enggsajjad/DataLogger/FPGA_Logger_R0000/main_pad.csv

Release 6.1i - Par G.23
Copyright (c) 1995-2003 Xilinx | Inc. All rights reserved.
Fri Nov 14 15:46:14 2014
NOTE: This file is designed to be imported into a spreadsheet program
such as Microsoft Excel for viewing | printing and sorting. The
character is used as the data field separator. This file is also designed
to support parsing.
INPUT FILE: main_map.ncd
OUTPUT FILE: main_pad.csv
PART TYPE: xc2s200
SPEED GRADE: -6
PACKAGE: pq208
Pinout by Pin Number:
----- | ----- | ----- | ----- | ----- | ----- | ----- | ----- | ----- | ----- | ----- | ----- | -----
Pin Number | Signal Name | Pin Usage | Pin Name | Direction | IO Standard | IO Bank Number | Drive (mA) | Slew Rate | Termination | IOB Delay | Voltage | Constraint
P1 |  |  | GND
P10 |  | IOB |  | UNUSED |  | (0 | 7)***
P100 | CSu | IOB | IO_VREF_4 | INPUT | LVTTL | (0 | 4)*** |  |  |  | NONE |  | LOCATED
P101 |  | IOB |  | UNUSED |  | (0 | 4)***
P102 |  | IOB |  | UNUSED |  | (0 | 4)***
P103 |  |  | GND
P104 |  |  | DONE
P105 |  |  | VCCO |  |  | 0 |  |  |  |  | 3.30
P106 |  |  | PROGRAM
P107 |  | IOB | IO_INIT | UNUSED |  | (0 | 3)***
P108 |  | IOB | IO_D7 | UNUSED |  | (0 | 3)***
P109 | sel_uart | IOB | IO_VREF_3 | INPUT | LVTTL | (0 | 3)*** |  |  |  | NONE |  | LOCATED
P11 |  |  | GND
P110 |  | IOB |  | UNUSED |  | (0 | 3)***
P111 | pCLK | IOB | IO_VREF_3 | OUTPUT | LVTTL | (0 | 3)*** | 12 | SLOW | NONE** |  |  | LOCATED
P112 |  | IOB |  | UNUSED |  | (0 | 3)***
P113 |  | IOB |  | UNUSED |  | (0 | 3)***
P114 |  | IOB | IO_VREF_3 | UNUSED |  | (0 | 3)***
P115 |  | IOB | IO_D6 | UNUSED |  | (0 | 3)***
P116 |  |  | GND
P117 |  |  | VCCO |  |  | 0 |  |  |  |  | 3.30
P118 |  |  | VCCINT |  |  |  |  |  |  |  | 2.5
P119 |  | IOB | IO_D5 | UNUSED |  | (0 | 3)***
P12 |  |  | VCCO |  |  | 0 |  |  |  |  | 3.30
P120 |  | IOB |  | UNUSED |  | (0 | 3)***
P121 |  | IOB |  | UNUSED |  | (0 | 3)***
P122 |  | IOB |  | UNUSED |  | (0 | 3)***
P123 |  | IOB |  | UNUSED |  | (0 | 3)***
P124 |  |  | GND
P125 |  | IOB | IO_VREF_3 | UNUSED |  | (0 | 3)***
P126 |  | IOB | IO_D4 | UNUSED |  | (0 | 3)***
P127 |  | IOB |  | UNUSED |  | (0 | 3)***
P128 |  |  | VCCINT |  |  |  |  |  |  |  | 2.5
P129 |  | PCIIOB | IO_TRDY | UNUSED |  | (0 | 3)***
P13 |  |  | VCCINT |  |  |  |  |  |  |  | 2.5
P130 |  |  | VCCO |  |  | 0 |  |  |  |  | 3.30
P131 |  |  | GND
P132 |  | PCIIOB | IO_IRDY | UNUSED |  | (0 | 2)***
P133 |  | IOB |  | UNUSED |  | (0 | 2)***
P134 |  | IOB |  | UNUSED |  | (0 | 2)***
P135 |  | IOB | IO_D3 | UNUSED |  | (0 | 2)***
P136 |  | IOB | IO_VREF_2 | UNUSED |  | (0 | 2)***
P137 |  |  | GND
P138 |  | IOB |  | UNUSED |  | (0 | 2)***
P139 |  | IOB |  | UNUSED |  | (0 | 2)***
P14 | sw<4> | IOB |  | INPUT | LVTTL | (0 | 7)*** |  |  |  | NONE |  | LOCATED
P140 |  | IOB |  | UNUSED |  | (0 | 2)***
P141 |  | IOB |  | UNUSED |  | (0 | 2)***
P142 |  | IOB | IO_D2 | UNUSED |  | (0 | 2)***
P143 |  |  | VCCINT |  |  |  |  |  |  |  | 2.5
P144 |  |  | VCCO |  |  | 0 |  |  |  |  | 3.30
P145 |  |  | GND
P146 |  | IOB | IO_D1 | UNUSED |  | (0 | 2)***
P147 | RXpc | IOB | IO_VREF_2 | OUTPUT | LVTTL | (0 | 2)*** | 12 | SLOW | NONE** |  |  | LOCATED
P148 | TXpc | IOB |  | INPUT | LVTTL | (0 | 2)*** |  |  |  | NONE |  | LOCATED
P149 |  | IOB |  | UNUSED |  | (0 | 2)***
P15 |  | IOB |  | UNUSED |  | (0 | 7)***
P150 |  | IOB | IO_VREF_2 | UNUSED |  | (0 | 2)***
P151 |  | IOB |  | UNUSED |  | (0 | 2)***
P152 |  | IOB | IO_VREF_2 | UNUSED |  | (0 | 2)***
P153 |  | IOB | IO_DIN_D0 | UNUSED |  | (0 | 2)***
P154 |  | IOB | IO_DOUT_BUSY | UNUSED |  | (0 | 2)***
P155 |  |  | CCLK
P156 |  |  | VCCO |  |  | 0 |  |  |  |  | 3.30
P157 |  |  | TDO
P158 |  |  | GND
P159 |  |  | TDI
P16 |  | IOB |  | UNUSED |  | (0 | 7)***
P160 |  | IOB | IO_CS | UNUSED |  | (0 | 1)***
P161 |  | IOB | IO_WRITE | UNUSED |  | (0 | 1)***
P162 | SCLK1 | IOB | IO_VREF_1 | OUTPUT | LVTTL | (0 | 1)*** | 12 | SLOW | NONE** |  |  | LOCATED
P163 |  | IOB |  | UNUSED |  | (0 | 1)***
P164 | CLK1 | IOB | IO_VREF_1 | OUTPUT | LVTTL | (0 | 1)*** | 12 | SLOW | NONE** |  |  | LOCATED
P165 |  | IOB |  | UNUSED |  | (0 | 1)***
P166 |  | IOB |  | UNUSED |  | (0 | 1)***
P167 |  | IOB | IO_VREF_1 | UNUSED |  | (0 | 1)***
P168 | CS1 | IOB |  | OUTPUT | LVTTL | (0 | 1)*** | 12 | SLOW | NONE** |  |  | LOCATED
P169 |  |  | GND
P17 |  | IOB |  | UNUSED |  | (0 | 7)***
P170 |  |  | VCCO |  |  | 0 |  |  |  |  | 3.30
P171 |  |  | VCCINT |  |  |  |  |  |  |  | 2.5
P172 | nDRDY | IOB |  | INPUT | LVTTL | (0 | 1)*** |  |  |  | IFD |  | LOCATED
P173 |  | IOB |  | UNUSED |  | (0 | 1)***
P174 | SDOUT1 | IOB |  | INPUT | LVTTL | (0 | 1)*** |  |  |  | IFD |  | LOCATED
P175 |  | IOB |  | UNUSED |  | (0 | 1)***
P176 | filter_clk | IOB |  | OUTPUT | LVTTL | (0 | 1)*** | 12 | SLOW | NONE** |  |  | LOCATED
P177 |  |  | GND
P178 | SYNC1 | IOB | IO_VREF_1 | OUTPUT | LVTTL | (0 | 1)*** | 12 | SLOW | NONE** |  |  | LOCATED
P179 |  | IOB |  | UNUSED |  | (0 | 1)***
P18 |  | IOB |  | UNUSED |  | (0 | 7)***
P180 |  | IOB |  | UNUSED |  | (0 | 1)***
P181 |  | IOB |  | UNUSED |  | (0 | 1)***
P182 | clk | GCLKIOB | GCK2 | INPUT | LVTTL | (0 | 1)*** |  |  |  |  |  | LOCATED
P183 |  |  | GND
P184 |  |  | VCCO |  |  | 0 |  |  |  |  | 3.30
P185 |  | GCLKIOB | GCK3 | UNUSED |  | 0
P186 |  |  | VCCINT |  |  |  |  |  |  |  | 2.5
P187 |  | IOB |  | UNUSED |  | 0
P188 |  | IOB |  | UNUSED |  | 0
P189 |  | IOB | IO_VREF_0 | UNUSED |  | 0
P19 |  |  | GND
P190 |  |  | GND
P191 |  | IOB |  | UNUSED |  | 0
P192 |  | IOB |  | UNUSED |  | 0
P193 |  | IOB |  | UNUSED |  | 0
P194 |  | IOB |  | UNUSED |  | 0
P195 |  | IOB |  | UNUSED |  | 0
P196 |  |  | VCCINT |  |  |  |  |  |  |  | 2.5
P197 |  |  | VCCO |  |  | 0 |  |  |  |  | 3.30
P198 |  |  | GND
P199 | relayAp | IOB |  | OUTPUT | LVTTL | 0 | 12 | SLOW | NONE** |  |  | LOCATED
P2 |  |  | TMS
P20 |  | IOB | IO_VREF_7 | UNUSED |  | (0 | 7)***
P200 |  | IOB | IO_VREF_0 | UNUSED |  | 0
P201 | relayAn | IOB |  | OUTPUT | LVTTL | 0 | 12 | SLOW | NONE** |  |  | LOCATED
P202 |  | IOB |  | UNUSED |  | 0
P203 | relayBp | IOB | IO_VREF_0 | OUTPUT | LVTTL | 0 | 12 | SLOW | NONE** |  |  | LOCATED
P204 |  | IOB |  | UNUSED |  | 0
P205 | relayBn | IOB | IO_VREF_0 | OUTPUT | LVTTL | 0 | 12 | SLOW | NONE** |  |  | LOCATED
P206 |  | IOB |  | UNUSED |  | 0
P207 |  |  | TCK
P208 |  |  | VCCO |  |  | 0 |  |  |  |  | 3.30
P21 |  | IOB |  | UNUSED |  | (0 | 7)***
P22 |  | IOB |  | UNUSED |  | (0 | 7)***
P23 |  | IOB |  | UNUSED |  | (0 | 7)***
P24 |  | PCIIOB | IO_IRDY | UNUSED |  | (0 | 7)***
P25 |  |  | GND
P26 |  |  | VCCO |  |  | 0 |  |  |  |  | 3.30
P27 |  | PCIIOB | IO_TRDY | UNUSED |  | (0 | 6)***
P28 |  |  | VCCINT |  |  |  |  |  |  |  | 2.5
P29 |  | IOB |  | UNUSED |  | (0 | 6)***
P3 | sw<0> | IOB |  | INPUT | LVTTL | (0 | 7)*** |  |  |  | NONE |  | LOCATED
P30 |  | IOB |  | UNUSED |  | (0 | 6)***
P31 |  | IOB | IO_VREF_6 | UNUSED |  | (0 | 6)***
P32 |  |  | GND
P33 |  | IOB |  | UNUSED |  | (0 | 6)***
P34 |  | IOB |  | UNUSED |  | (0 | 6)***
P35 |  | IOB |  | UNUSED |  | (0 | 6)***
P36 |  | IOB |  | UNUSED |  | (0 | 6)***
P37 |  | IOB |  | UNUSED |  | (0 | 6)***
P38 |  |  | VCCINT |  |  |  |  |  |  |  | 2.5
P39 |  |  | VCCO |  |  | 0 |  |  |  |  | 3.30
P4 |  | IOB | IO_VREF_7 | UNUSED |  | (0 | 7)***
P40 |  |  | GND
P41 | CSe<1> | IOB |  | OUTPUT | LVTTL | (0 | 6)*** | 12 | SLOW | NONE** |  |  | LOCATED
P42 |  | IOB | IO_VREF_6 | UNUSED |  | (0 | 6)***
P43 | SCLKe | IOB |  | OUTPUT | LVTTL | (0 | 6)*** | 12 | SLOW | NONE** |  |  | LOCATED
P44 |  | IOB |  | UNUSED |  | (0 | 6)***
P45 | SDINe | IOB | IO_VREF_6 | OUTPUT | LVTTL | (0 | 6)*** | 12 | SLOW | NONE** |  |  | LOCATED
P46 |  | IOB |  | UNUSED |  | (0 | 6)***
P47 | SDOUTe | IOB | IO_VREF_6 | INPUT | LVTTL | (0 | 6)*** |  |  |  | NONE |  | LOCATED
P48 |  | IOB |  | UNUSED |  | (0 | 6)***
P49 | CSe<0> | IOB |  | OUTPUT | LVTTL | (0 | 6)*** | 12 | SLOW | NONE** |  |  | LOCATED
P5 | sw<1> | IOB |  | INPUT | LVTTL | (0 | 7)*** |  |  |  | NONE |  | LOCATED
P50 |  |  | M1
P51 |  |  | GND
P52 |  |  | M0
P53 |  |  | VCCO |  |  | 0 |  |  |  |  | 3.30
P54 |  |  | M2
P57 |  | IOB | IO_VREF_5 | UNUSED |  | (0 | 5)***
P58 |  | IOB |  | UNUSED |  | (0 | 5)***
P59 |  | IOB | IO_VREF_5 | UNUSED |  | (0 | 5)***
P6 |  | IOB | IO_VREF_7 | UNUSED |  | (0 | 7)***
P60 |  | IOB |  | UNUSED |  | (0 | 5)***
P61 | data_done | IOB |  | OUTPUT | LVTTL | (0 | 5)*** | 12 | SLOW | NONE** |  |  | LOCATED
P62 |  | IOB | IO_VREF_5 | UNUSED |  | (0 | 5)***
P63 | start_pulse | IOB |  | INPUT | LVTTL | (0 | 5)*** |  |  |  | IFD |  | LOCATED
P64 |  |  | GND
P65 |  |  | VCCO |  |  | 0 |  |  |  |  | 3.30
P66 |  |  | VCCINT |  |  |  |  |  |  |  | 2.5
P67 |  | IOB |  | UNUSED |  | (0 | 5)***
P68 | reset | IOB |  | INPUT | LVTTL | (0 | 5)*** |  |  |  | NONE |  | LOCATED
P69 |  | IOB |  | UNUSED |  | (0 | 5)***
P7 | sw<2> | IOB |  | INPUT | LVTTL | (0 | 7)*** |  |  |  | NONE |  | LOCATED
P70 |  | IOB |  | UNUSED |  | (0 | 5)***
P71 | CSe<3> | IOB |  | OUTPUT | LVTTL | (0 | 5)*** | 12 | SLOW | NONE**
P72 |  |  | GND
P73 | CSe<2> | IOB | IO_VREF_5 | OUTPUT | LVTTL | (0 | 5)*** | 12 | SLOW | NONE**
P74 |  | IOB |  | UNUSED |  | (0 | 5)***
P75 |  | IOB |  | UNUSED |  | (0 | 5)***
P76 |  |  | VCCINT |  |  |  |  |  |  |  | 2.5
P77 |  | GCLKIOB | GCK1 | UNUSED |  | (0 | 5)***
P78 |  |  | VCCO |  |  | 0 |  |  |  |  | 3.30
P79 |  |  | GND
P8 |  | IOB |  | UNUSED |  | (0 | 7)***
P80 |  | GCLKIOB | GCK0 | UNUSED |  | (0 | 4)***
P81 |  | IOB |  | UNUSED |  | (0 | 4)***
P82 |  | IOB |  | UNUSED |  | (0 | 4)***
P83 |  | IOB |  | UNUSED |  | (0 | 4)***
P84 | RXu | IOB | IO_VREF_4 | OUTPUT | LVTTL | (0 | 4)*** | 12 | SLOW | NONE** |  |  | LOCATED
P85 |  |  | GND
P86 | TXu | IOB |  | INPUT | LVTTL | (0 | 4)*** |  |  |  | NONE |  | LOCATED
P87 |  | IOB |  | UNUSED |  | (0 | 4)***
P88 | SDOUTu | IOB |  | INPUT | LVTTL | (0 | 4)*** |  |  |  | NONE |  | LOCATED
P89 |  | IOB |  | UNUSED |  | (0 | 4)***
P9 | sw<3> | IOB | IO_VREF_7 | INPUT | LVTTL | (0 | 7)*** |  |  |  | NONE |  | LOCATED
P90 | SDINu | IOB |  | OUTPUT | LVTTL | (0 | 4)*** | 12 | SLOW | NONE** |  |  | LOCATED
P91 |  |  | VCCINT |  |  |  |  |  |  |  | 2.5
P92 |  |  | VCCO |  |  | 0 |  |  |  |  | 3.30
P93 |  |  | GND
P94 | SCLKu | IOB |  | INPUT | LVTTL | (0 | 4)*** |  |  |  | NONE |  | LOCATED
P95 |  | IOB | IO_VREF_4 | UNUSED |  | (0 | 4)***
P96 |  | IOB |  | UNUSED |  | (0 | 4)***
P97 |  | IOB |  | UNUSED |  | (0 | 4)***
P98 |  | IOB | IO_VREF_4 | UNUSED |  | (0 | 4)***
P99 |  | IOB |  | UNUSED |  | (0 | 4)***
----- | ----- | ----- | ----- | ----- | ----- | ----- | ----- | ----- | ----- | ----- | ----- | -----
* Default value.
** This default Pullup/Pulldown value can be overridden in Bitgen.
*** In some smaller packages | the VCCO bank number of a pin may trail
the VREF bank number (VCCO | VREF).
