enggsajjad/DataLogger/ICCC-PD-24-PCBR0500/data logger-68.dxf

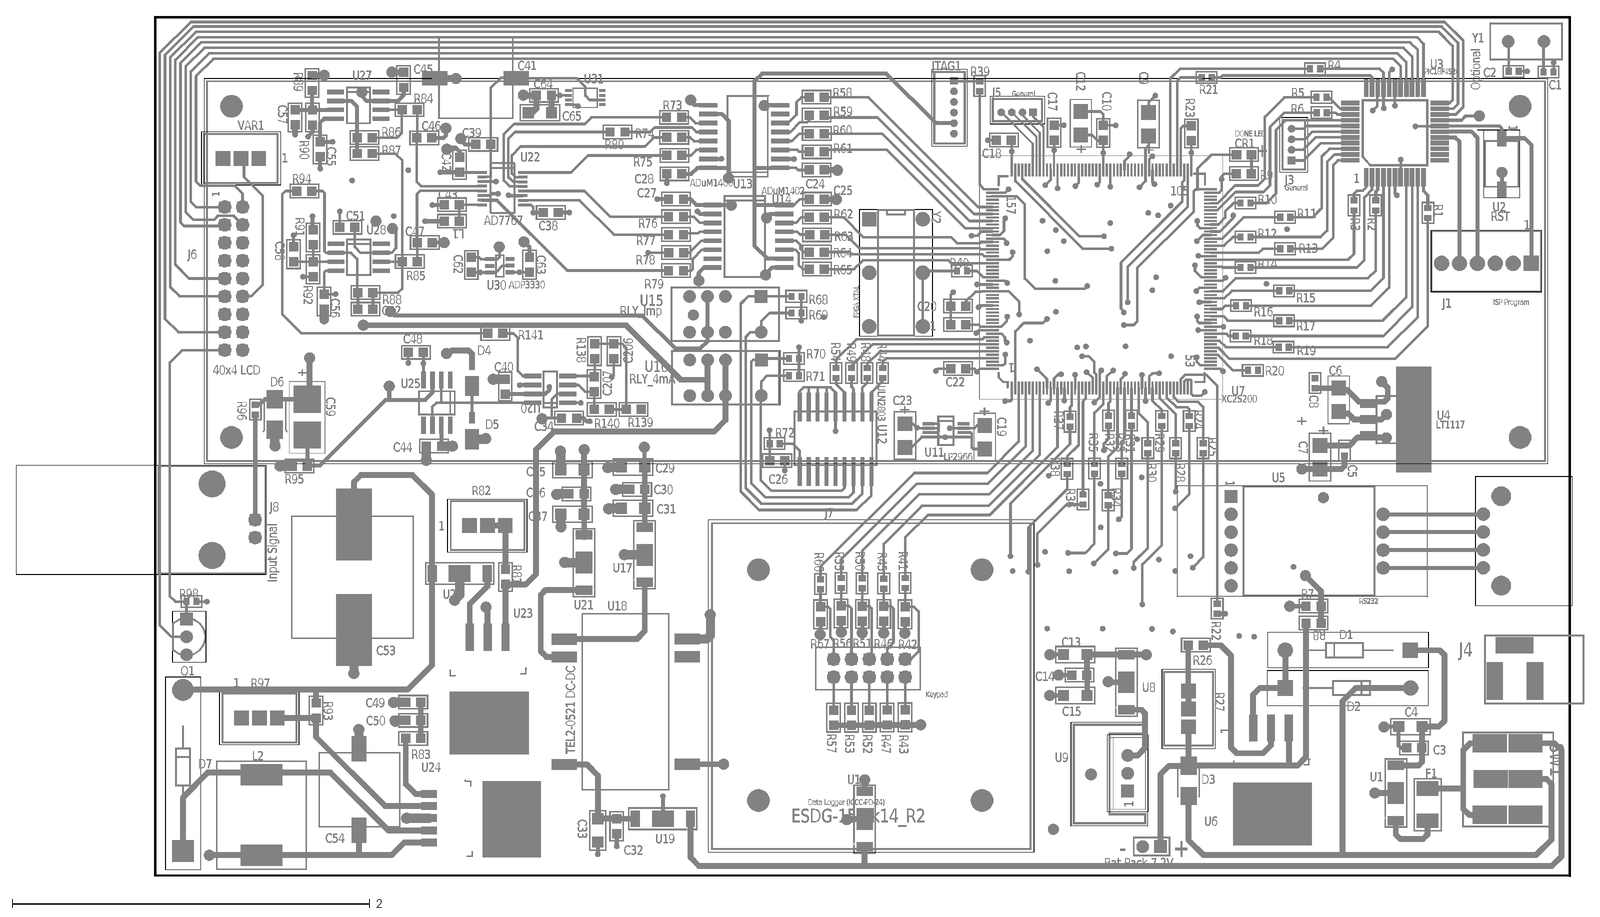
[picture p1: CAD file, 2022-11-24]
ICCC-PD-24-PCBR0500/data logger-68.dxf
U30
U23
U25
U27
U28
U1
U10
U8
U19
U17
U21
U26
C54
C53
C41
L2
C12
+
U18
U31
R71
J8
1
R27
R97
R82
VAR1
D7
J7
R22
J1
U5
C43
R15
C14
C27
C28
C13
C40
C37
R4
C15
C38
L1
C50
C65
C36
R28
R84
C64
C35
F1
R38
C55
R1
U24
U15
C45
U12
U20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
