enggsajjad/DataLogger/(list of files, cad)

Other CAD files:
FPGA_Logger_R0000/work/adc/verilog.psm
FPGA_Logger_R0000/work/buttons/verilog.psm
FPGA_Logger_R0000/work/cu_rx/verilog.psm
FPGA_Logger_R0000/work/glbl/verilog.psm
FPGA_Logger_R0000/work/relays/verilog.psm
FPGA_Logger_R0000/work/tf_adc/verilog.psm
FPGA_Logger_R0000/work/tf_button/verilog.psm
FPGA_Logger_R0000/work/tf_cu_rx/verilog.psm
FPGA_Logger_R0000/work/tf_relays/verilog.psm
FPGA_Logger_R0000/work/uart_rx/verilog.psm
