enggsajjad/DataLogger/ICCC-PD-24-PCBR0500/pdf/schematic.pdf

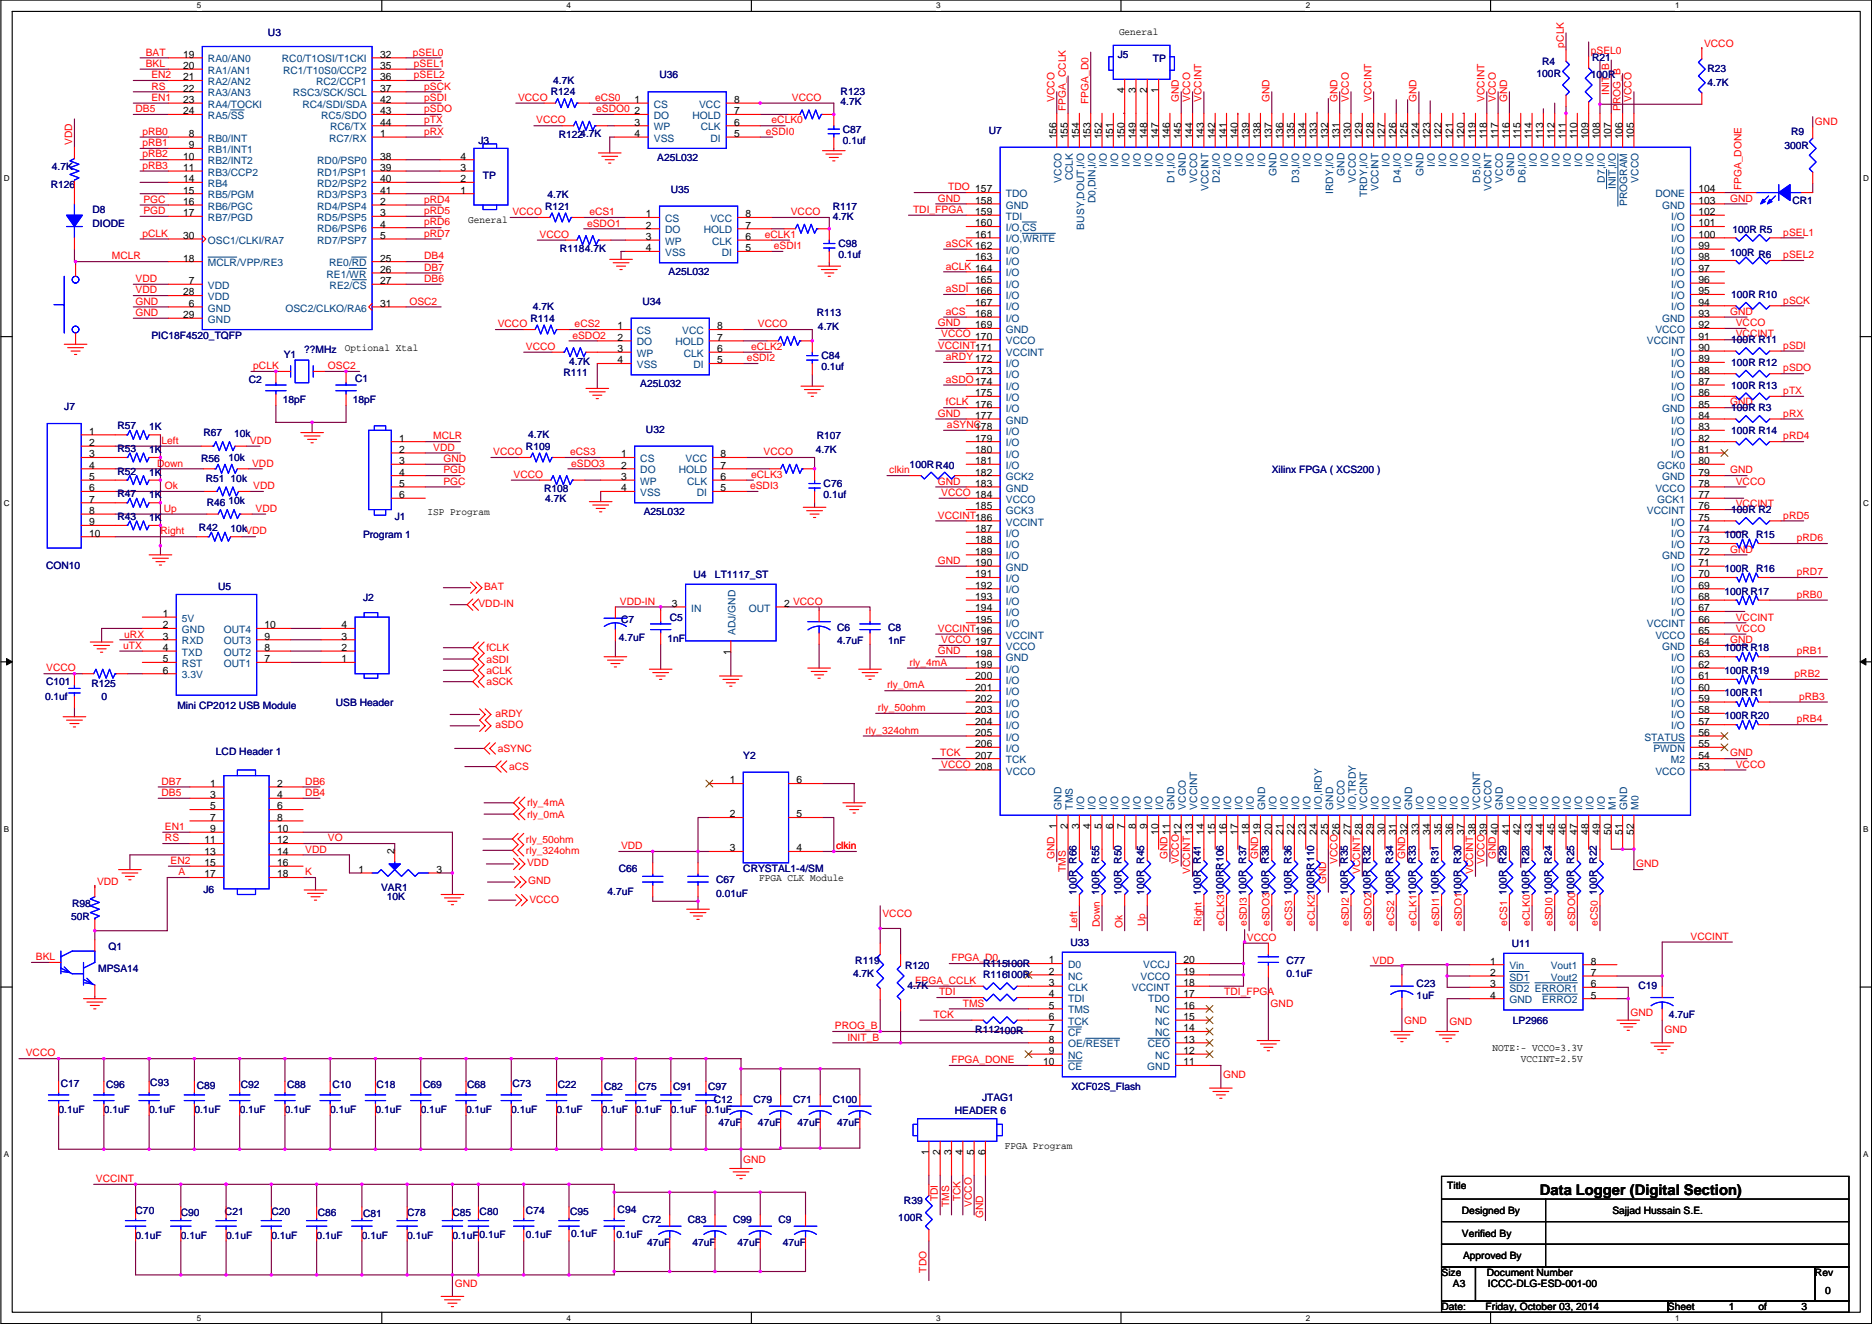
[picture p2: page 1]

ADJ/GND 1 IN 3 OUT 2

Data Logger (Digital Section)

Designed By Designed By Designed By | Sajjad Hussain S.E. Sajjad Hussain S.E. Sajjad Hussain S.E.

Verified By Verified By Verified By

Approved By
Size A3 | Document Number ICCC-DLG-ESD-001-00 | Rev 0

Date: Friday, October 03, 2014 Friday, October 03, 2014 Friday, October 03, 2014 | Sheet 1 1 1 of 3 3 3

VDD-IN | VDD

## VDD

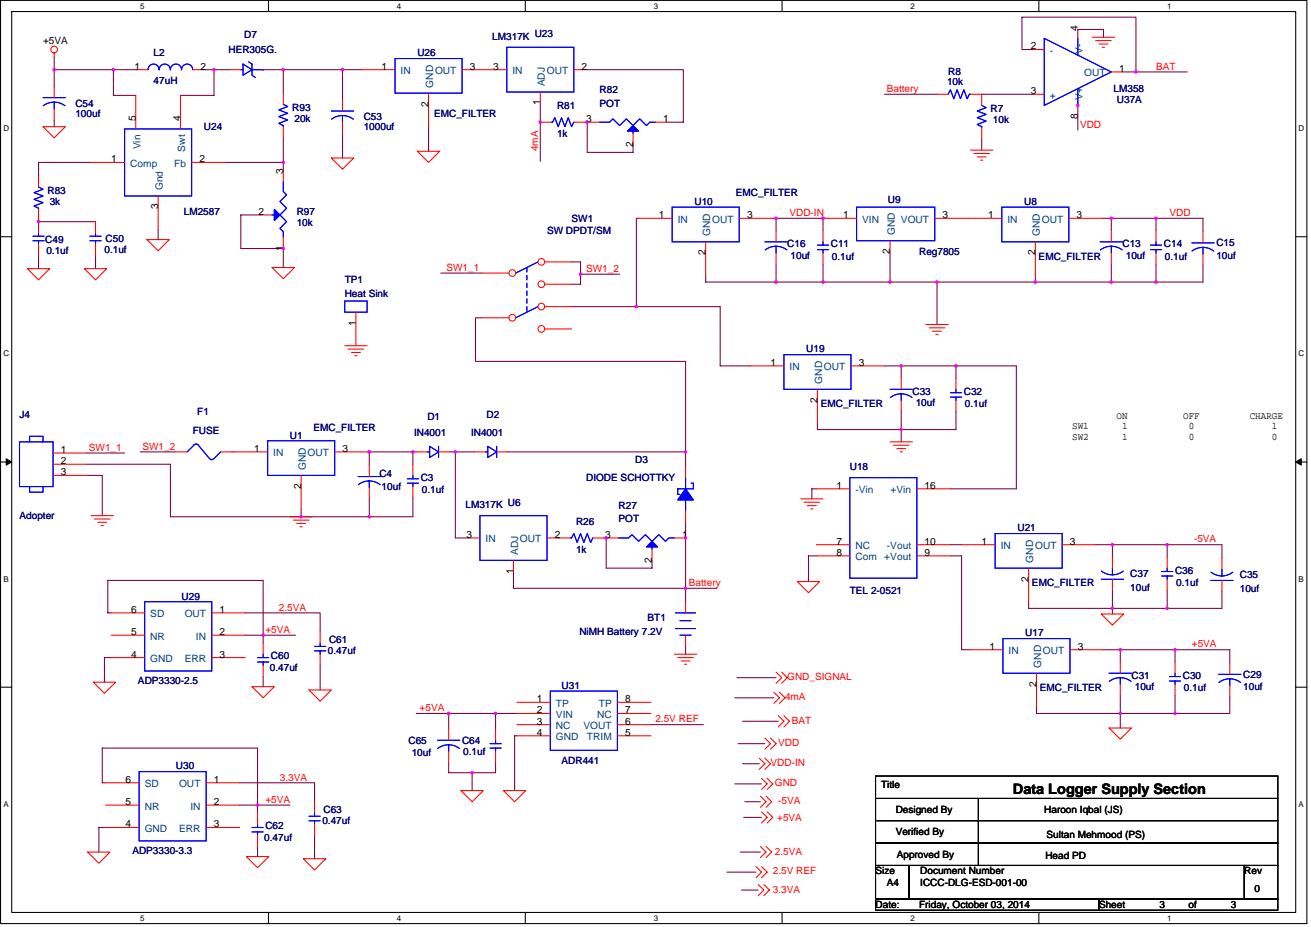
[picture p3: page 2]

Data Logger Supply Section

Designed By Designed By Designed By | Haroon Iqbal (JS) Haroon Iqbal (JS) Haroon Iqbal (JS)

Verified By Verified By Verified By | Sultan Mehmood (PS) Sultan Mehmood (PS) Sultan Mehmood (PS)

Head PD Head PD Head PD

+5VA

+5VA

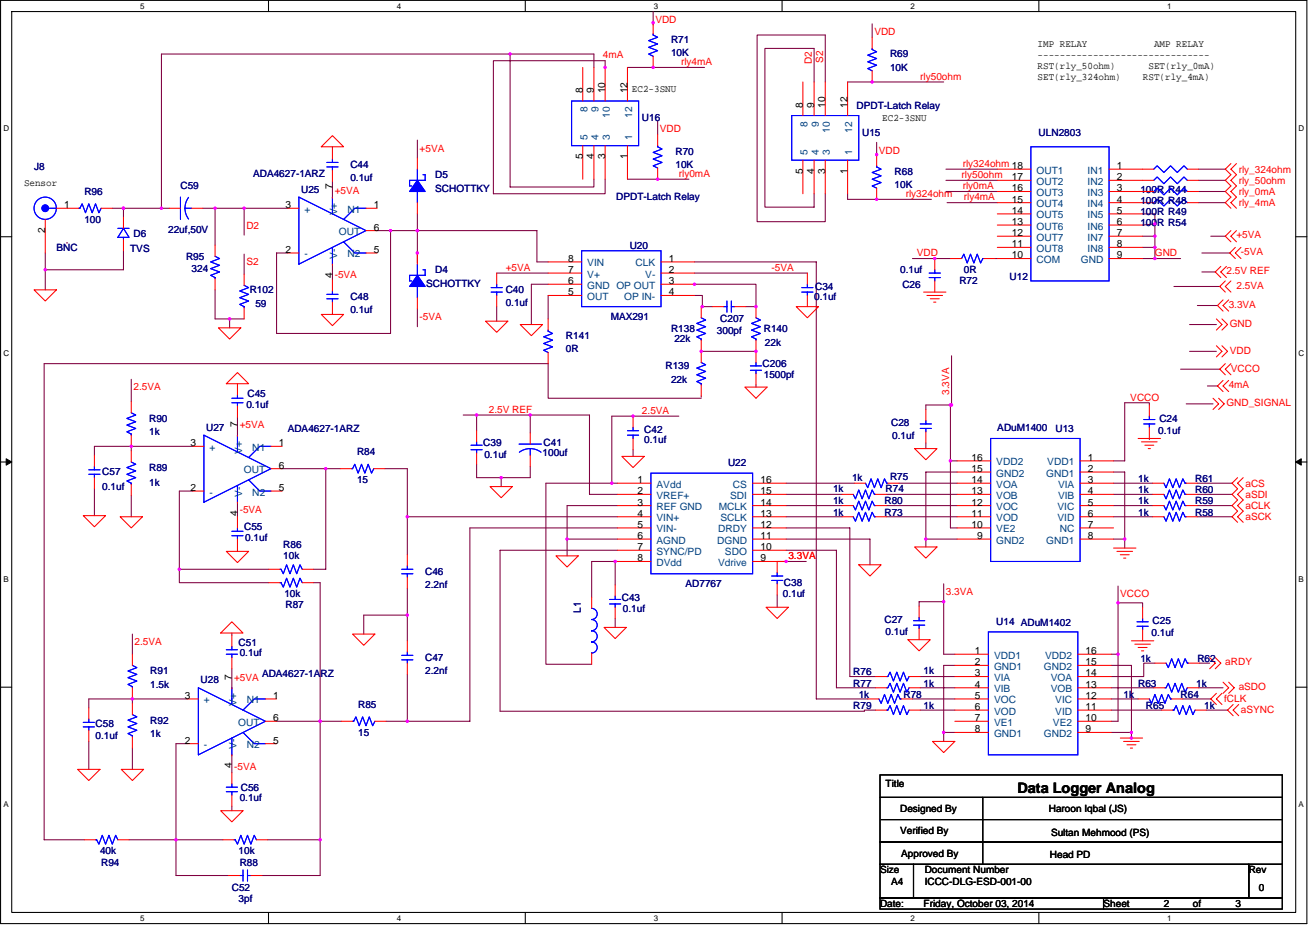
[picture p4: page 3]

Designed By Designed By Designed By | Haroon Iqbal (JS) Haroon Iqbal (JS) Haroon Iqbal (JS)

Verified By Verified By Verified By | Sultan Mehmood (PS) Sultan Mehmood (PS) Sultan Mehmood (PS)
