enggsajjad/DataLogger/ICCC-PD-24-PCBR0500/pdf/CompleteBottomLayers.pdf

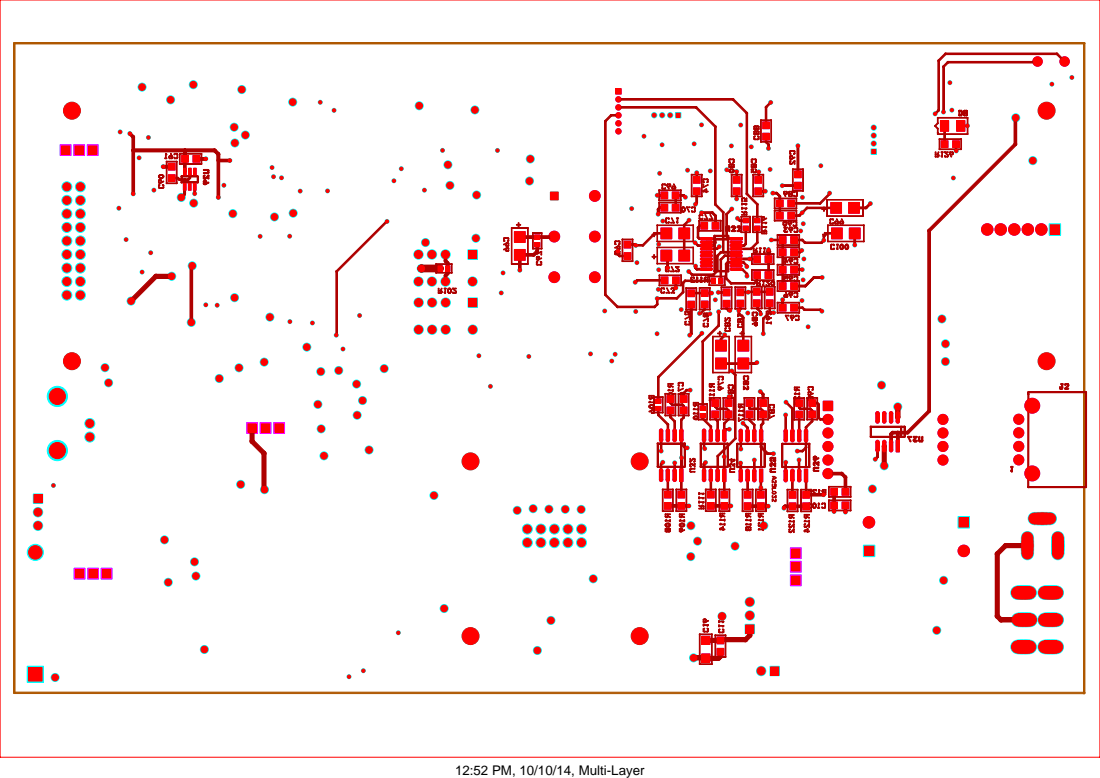
[picture p5: page 1]

12:52 PM, 10/10/14, Multi-Layer
