enggsajjad/DataLogger/ICCC-PD-24-PCBR0500/pdf/CompleteBottomLayers_Gray.pdf

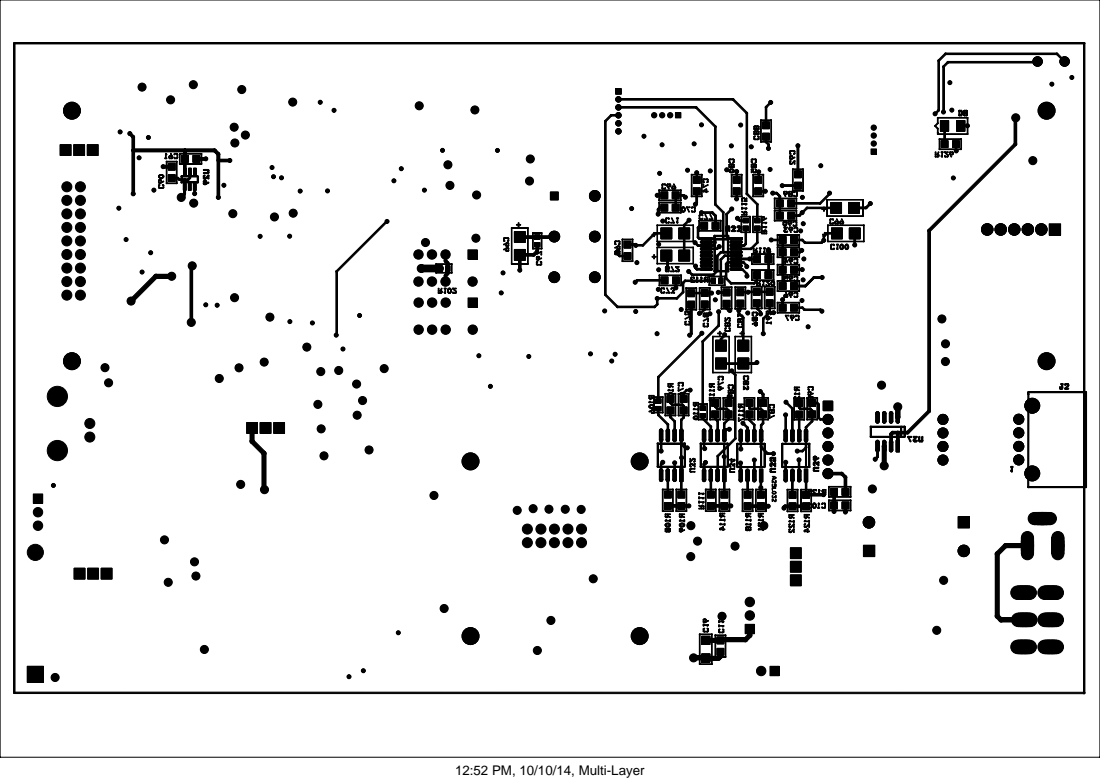
[picture p6: page 1]

12:52 PM, 10/10/14, Multi-Layer
