enggsajjad/DataLogger/ICCC-PD-24-PCBR0500/pdf/CompleteLayersExceptInner.pdf

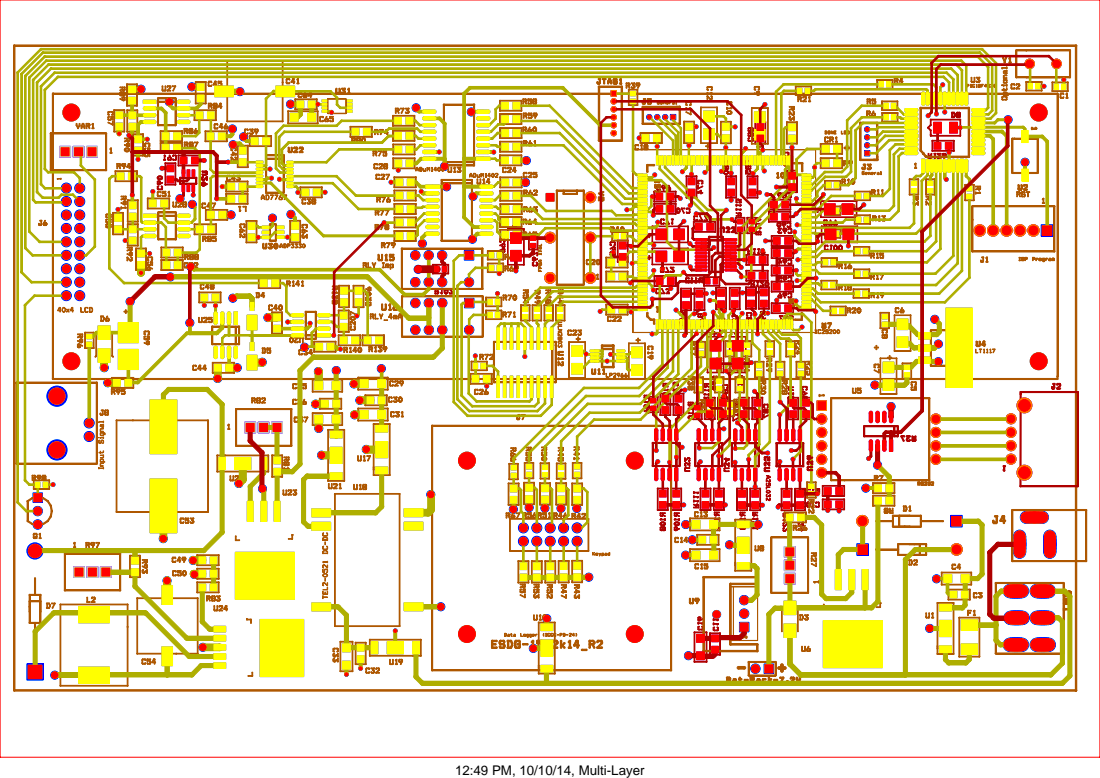
[picture p7: page 1]

12:49 PM, 10/10/14, Multi-Layer
