enggsajjad/DataLogger/ICCC-PD-24-PCBR0500/pdf/CompleteTopLayers.pdf

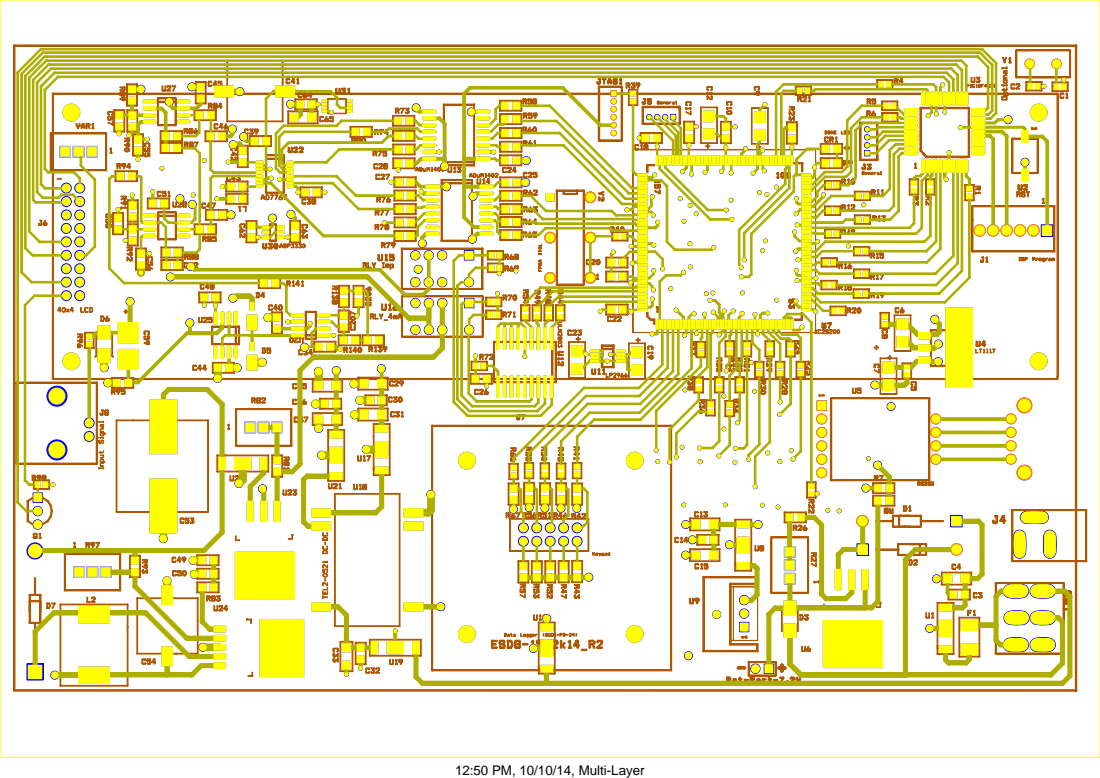
[picture p8: page 1]

12:50 PM, 10/10/14, Multi-Layer
