enggsajjad/DataLogger/ICCC-PD-24-PCBR0500/pdf/CompleteTopLayers_Gray.pdf

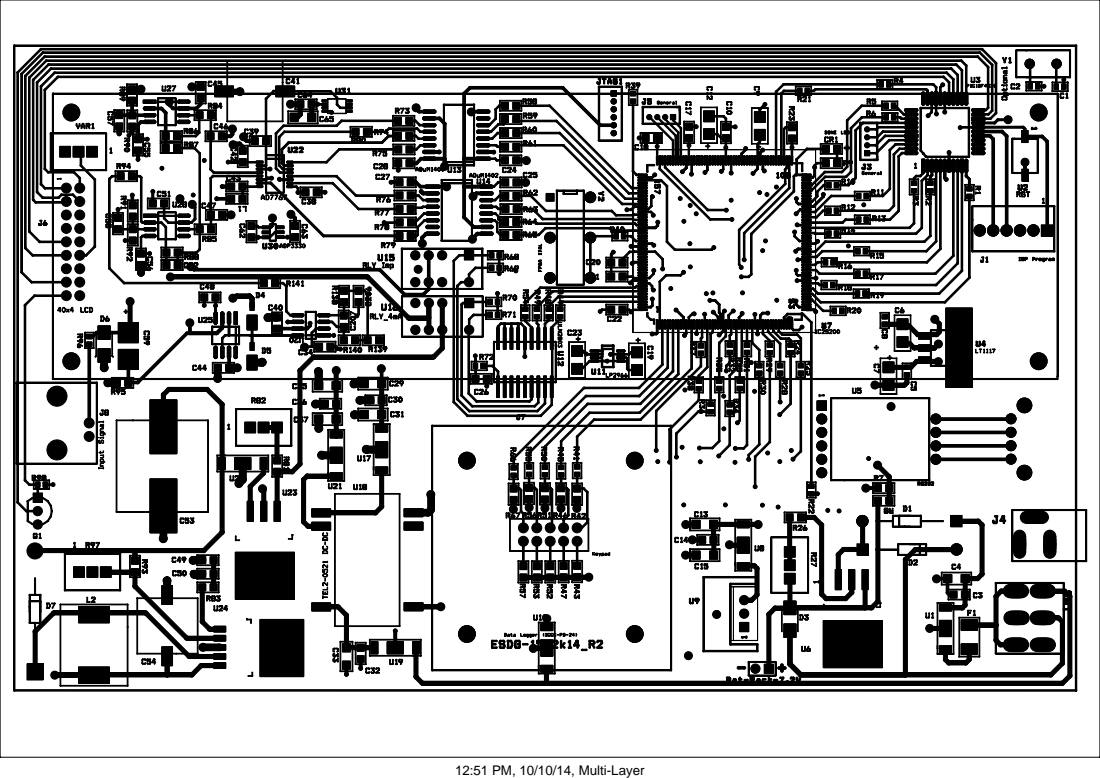
[picture p9: page 1]

12:51 PM, 10/10/14, Multi-Layer
