enggsajjad/DataLogger/(list of files, drawings)

Other design files:
ICCC-PD-24-PCBR0500/DATA LOGGER.DSN
ICCC-PD-24-PCBR0500/Data Logger.opj
ICCC-PD-24-PCBR0500/LIBRARY1.OLB
ICCC-PD-24-PCBR0500/LIBRARY2.OLB
